MrGaintsquirrel/Kicad_lib/3D drawings/SK34A.step

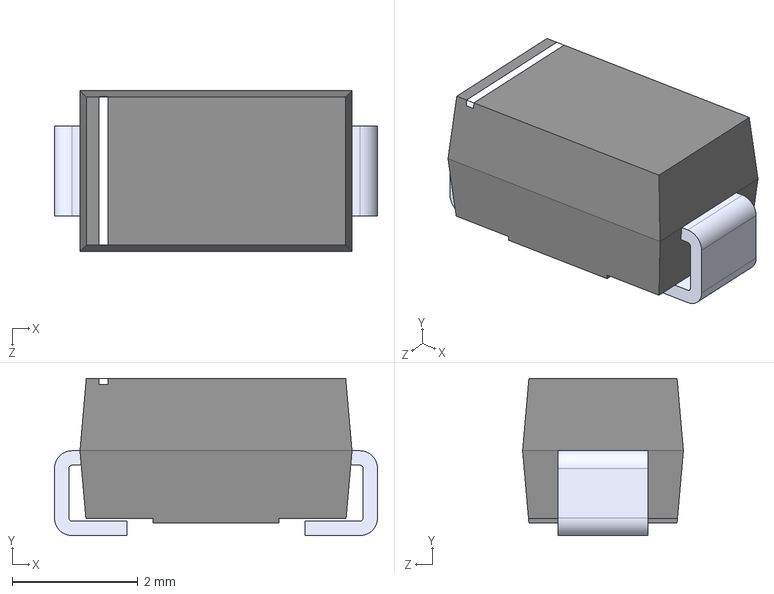
[picture p1: CAD file, 2023-05-01]
3D drawings/SK34A.step
5.14 x 2.50 x 2.56 mm
