MrGaintsquirrel/Kicad_lib/Capacitors/3D_Models/C_0402_1005Metric.step

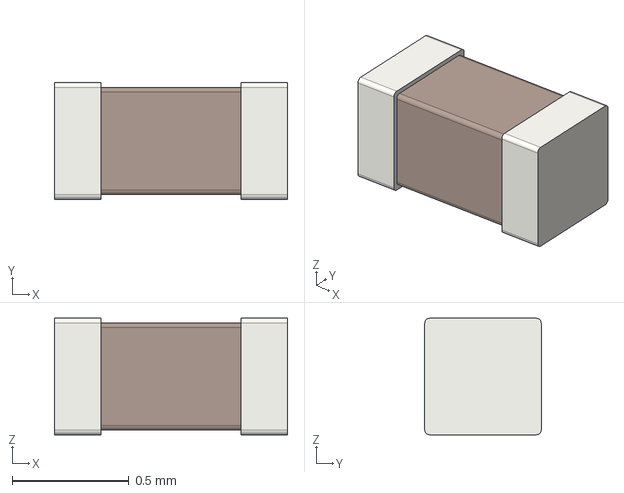
[picture p2: CAD file, 2026-04-26]
Capacitors/3D_Models/C_0402_1005Metric.step
1.00 x 0.5 x 0.5 mm
