MrGaintsquirrel/Kicad_lib/Resistors/3D_Models/R_0402_1005Metric.step

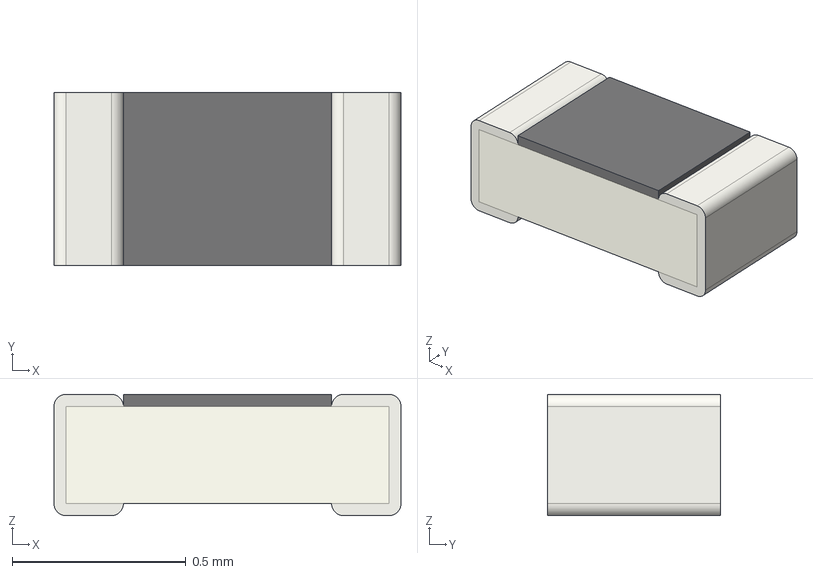
[picture p3: CAD file, 2026-04-26]
Resistors/3D_Models/R_0402_1005Metric.step
1.00 x 0.5 x 0.35 mm
