MrGaintsquirrel/Kicad_lib/STMicroelectronics/3D_Models/STM_LQFP32_5V_LQFP32_ME_V1.step

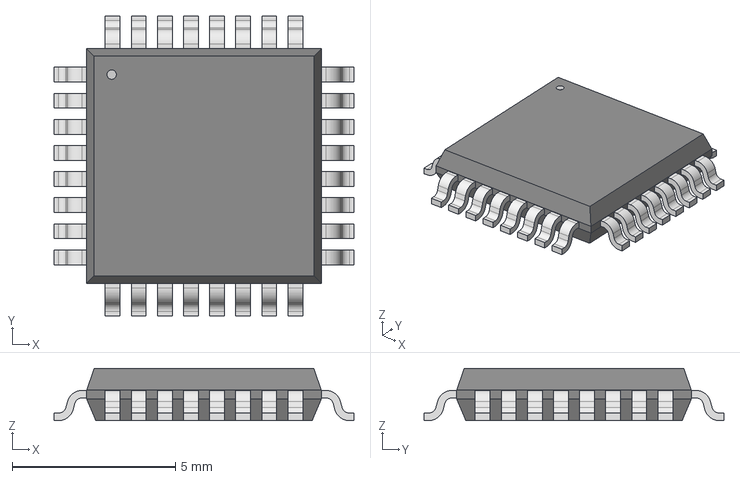
[picture p4: CAD file, 2026-04-29]
STMicroelectronics/3D_Models/STM_LQFP32_5V_LQFP32_ME_V1.step
9.19 x 9.19 x 1.60 mm
