MrGaintsquirrel/Kicad_lib/3D drawings/TO254P1524X483-4N.step

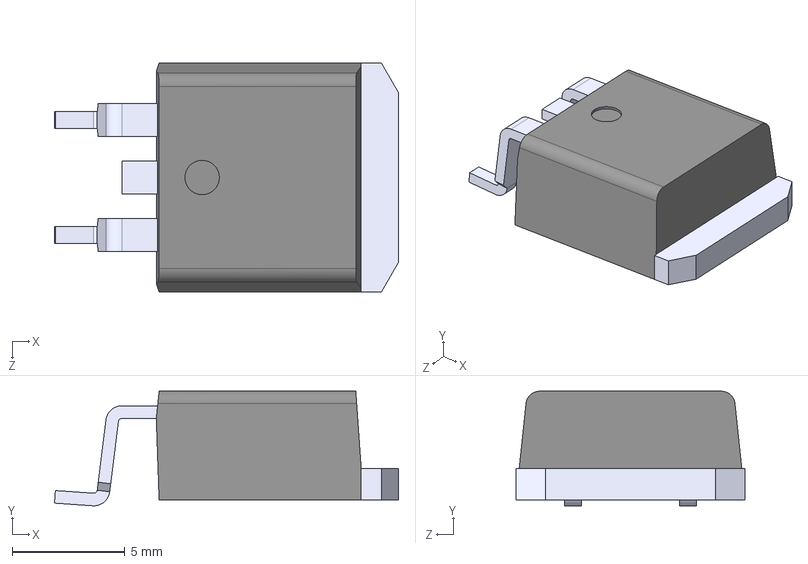
[picture p5: CAD file, 2023-05-01]
3D drawings/TO254P1524X483-4N.step
15.2 x 5.08 x 10.2 mm
