MrGaintsquirrel/Kicad_lib/Capacitors/3D_Models/C_0805_2012Metric.step

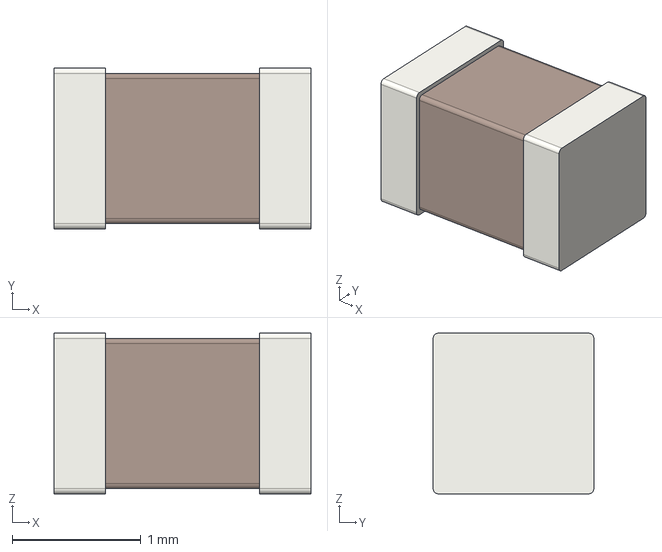
[picture p6: CAD file, 2026-04-26]
Capacitors/3D_Models/C_0805_2012Metric.step
2.00 x 1.25 x 1.25 mm
