MrGaintsquirrel/Kicad_lib/Resistors/3D_Models/R_0805_2012Metric.step

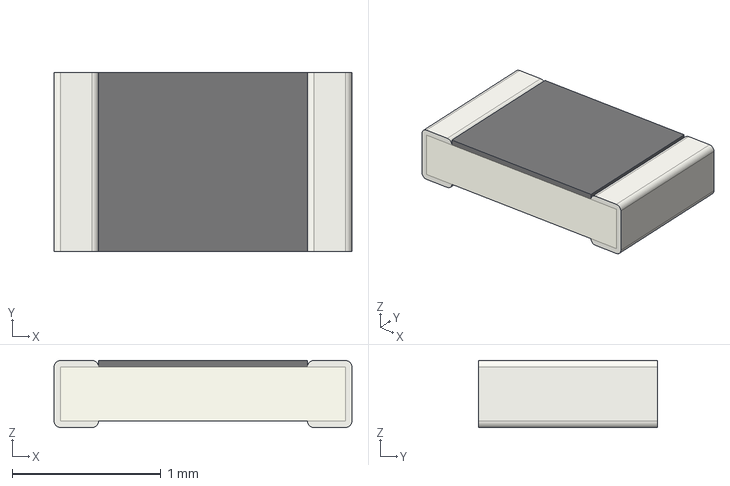
[picture p7: CAD file, 2026-04-26]
Resistors/3D_Models/R_0805_2012Metric.step
2.00 x 1.20 x 0.45 mm
