MrGaintsquirrel/Kicad_lib/STMicroelectronics/3D_Models/STM_UFQFPN48_A0B9_UFQFPN48_ME_V4.step

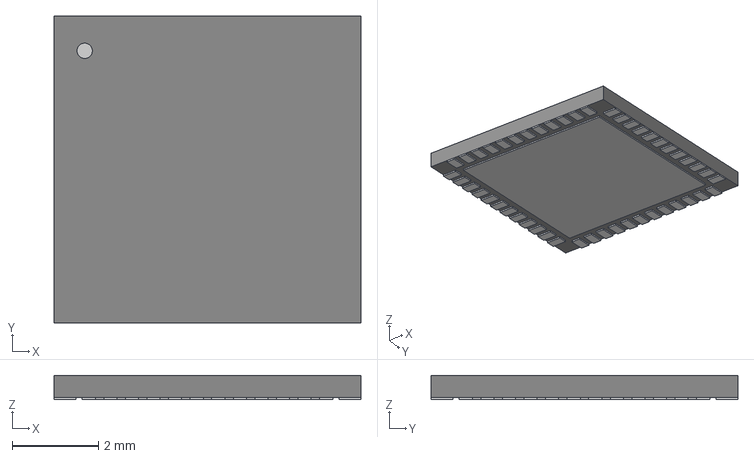
[picture p8: CAD file, 2026-04-29]
STMicroelectronics/3D_Models/STM_UFQFPN48_A0B9_UFQFPN48_ME_V4.step
7.11 x 7.11 x 0.561 mm
