MrGaintsquirrel/Kicad_lib/3D drawings/SRP7050TA.stp

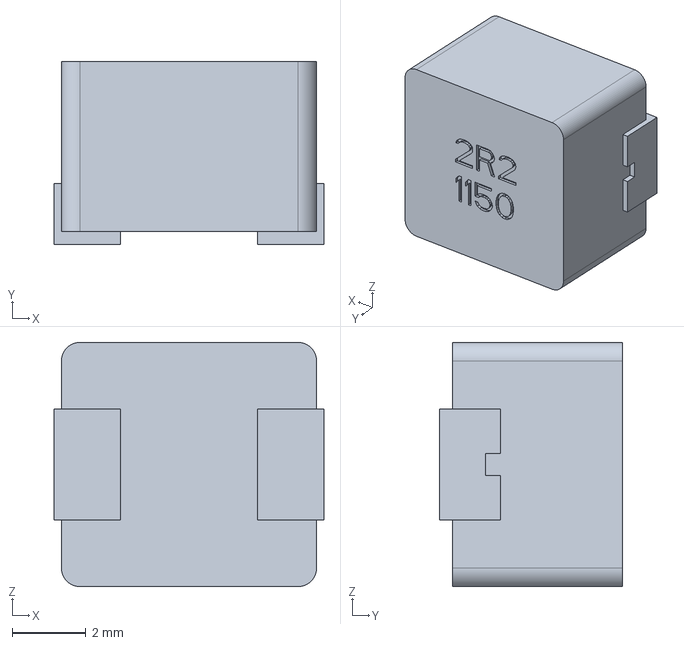
[picture p9: CAD file, 2023-05-01]
3D drawings/SRP7050TA.stp
7.30 x 4.95 x 6.60 mm
