MrGaintsquirrel/Kicad_lib/Capacitors/3D_Models/C_0603_1608Metric.step

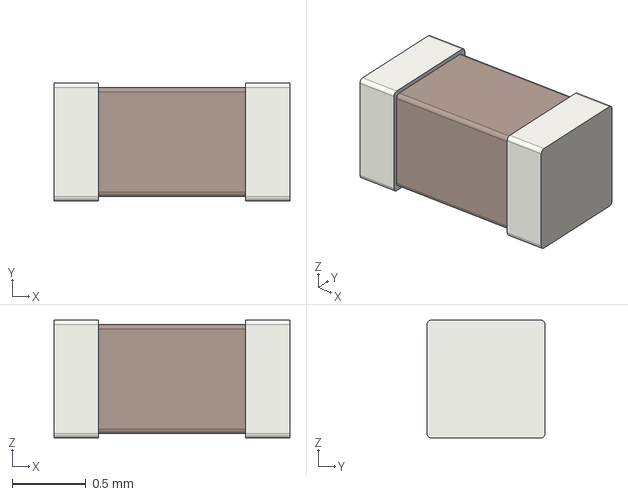
[picture p10: CAD file, 2026-04-26]
Capacitors/3D_Models/C_0603_1608Metric.step
1.60 x 0.8 x 0.8 mm
