MrGaintsquirrel/Kicad_lib/Resistors/3D_Models/R_0603_1608Metric.step

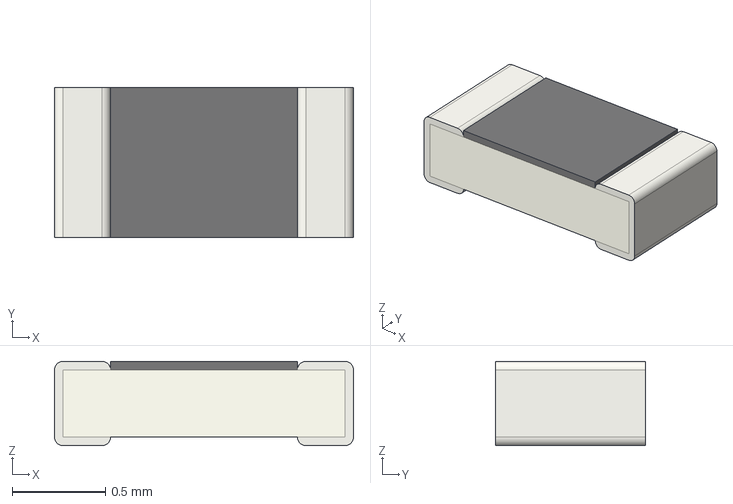
[picture p11: CAD file, 2026-04-26]
Resistors/3D_Models/R_0603_1608Metric.step
1.60 x 0.8 x 0.45 mm
