MrGaintsquirrel/Kicad_lib/STMicroelectronics/3D_Models/STM_UFQFPN24_3Z_UFQFPN24_ME_V3.step

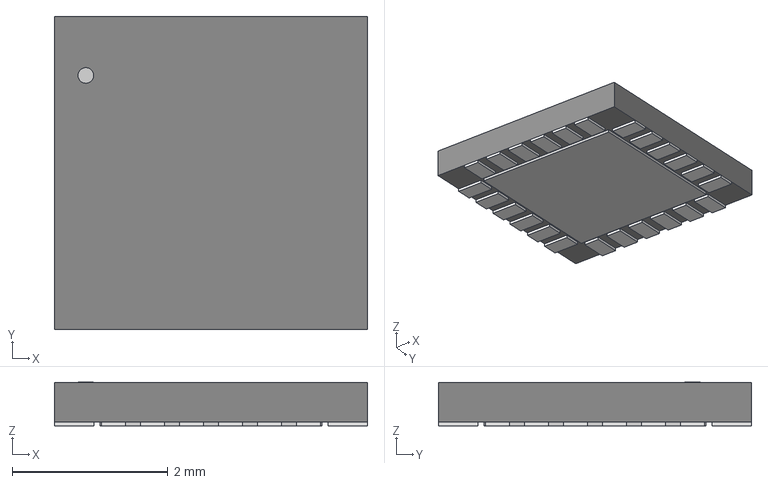
[picture p12: CAD file, 2026-04-29]
STMicroelectronics/3D_Models/STM_UFQFPN24_3Z_UFQFPN24_ME_V3.step
4.01 x 4.01 x 0.561 mm
