MrGaintsquirrel/Kicad_lib/3D drawings/W25Q128JVSIM.stp

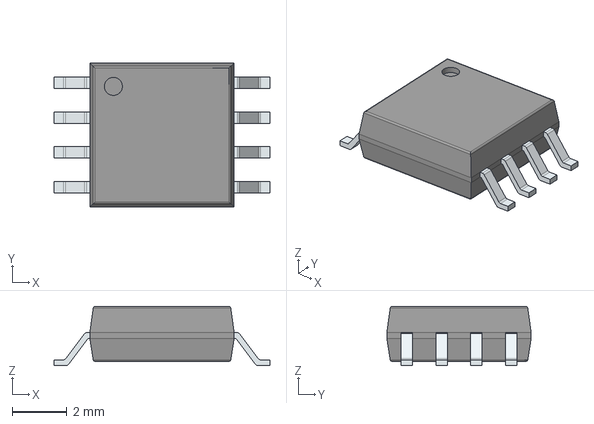
[picture p13: CAD file, 2023-05-01]
3D drawings/W25Q128JVSIM.stp
7.90 x 5.28 x 2.16 mm
PinsArrayLR
