MrGaintsquirrel/Kicad_lib/STMicroelectronics/3D_Models/STM_TSSOP20_YA_ME_V3.step

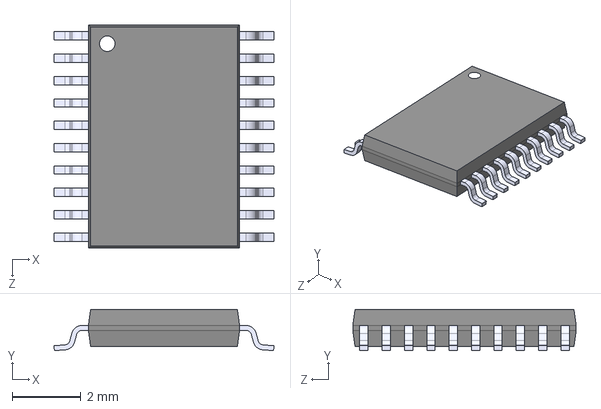
[picture p14: CAD file, 2026-04-29]
STMicroelectronics/3D_Models/STM_TSSOP20_YA_ME_V3.step
6.40 x 1.20 x 6.50 mm
