MrGaintsquirrel/Kicad_lib/3D drawings/MIC2920A-3.3WS-TR.STEP

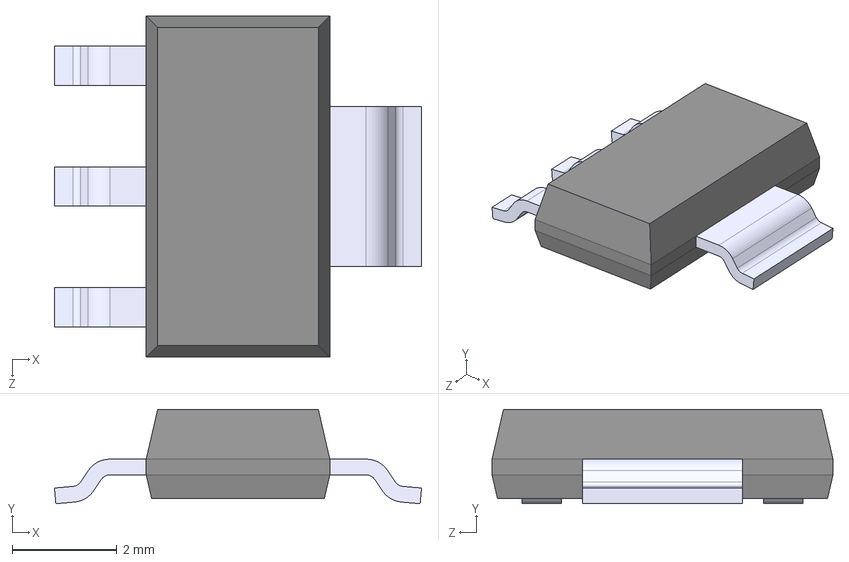
[picture p15: CAD file, 2023-05-01]
3D drawings/MIC2920A-3.3WS-TR.STEP
7.00 x 1.80 x 6.50 mm
