MrGaintsquirrel/Kicad_lib/STMicroelectronics/3D_Models/STM_LQFP64_5W_LQFP64_ME_V1.step

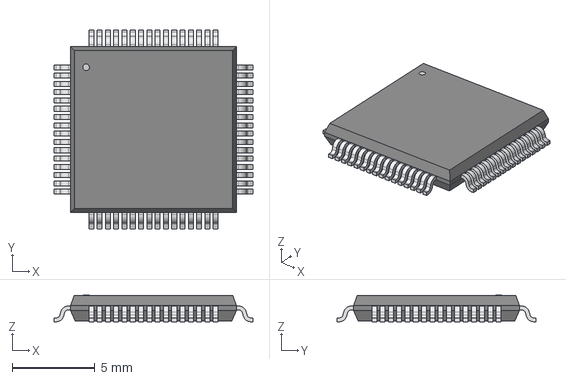
[picture p16: CAD file, 2026-04-29]
STMicroelectronics/3D_Models/STM_LQFP64_5W_LQFP64_ME_V1.step
12.0 x 12.0 x 1.60 mm
