MrGaintsquirrel/Kicad_lib/3D drawings/USB4110-GF-A--3DModel-STEP-269445.STEP

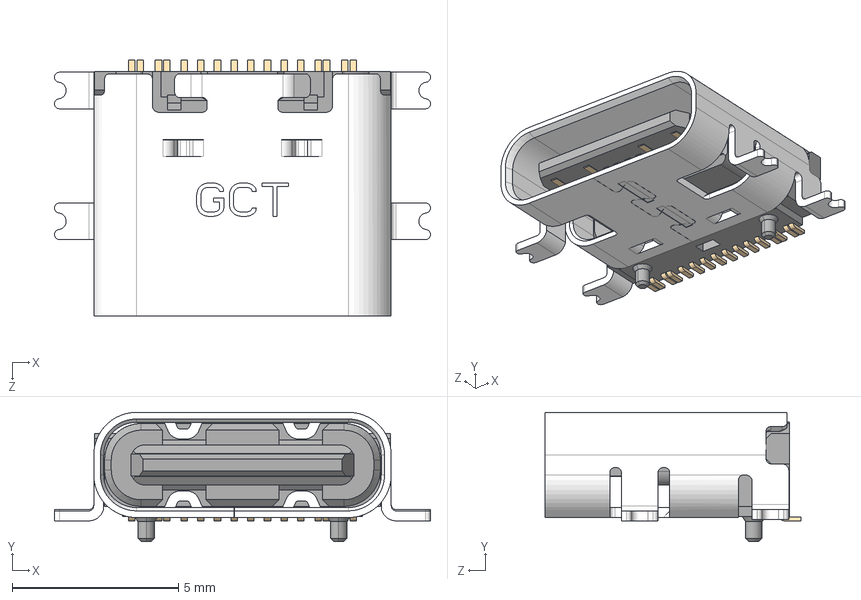
[picture p17: CAD file, 2023-02-09]
3D drawings/USB4110-GF-A--3DModel-STEP-269445.STEP
11.3 x 3.89 x 7.70 mm
