MrGaintsquirrel/Kicad_lib/STMicroelectronics/3D_Models/STM_LQFP48_5B_LQFP48_ME_V1.step

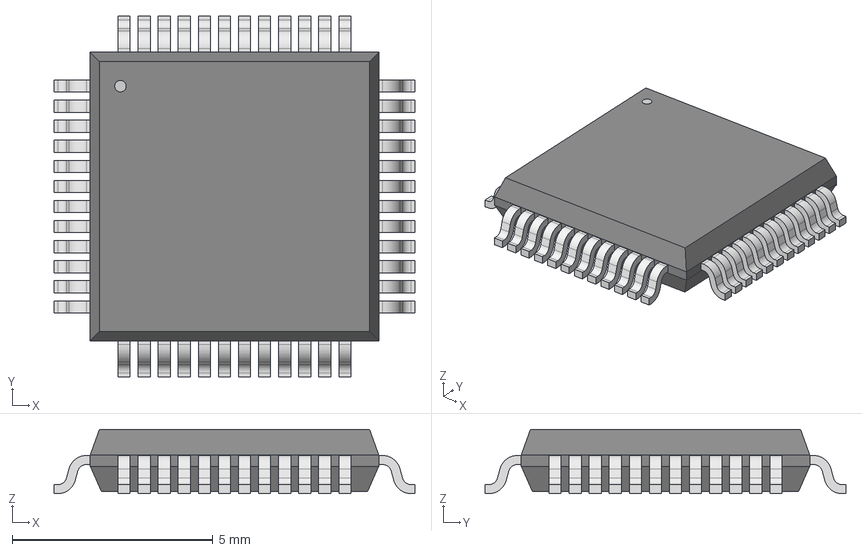
[picture p18: CAD file, 2026-04-29]
STMicroelectronics/3D_Models/STM_LQFP48_5B_LQFP48_ME_V1.step
8.99 x 8.99 x 1.60 mm
