MrGaintsquirrel/Kicad_lib/3D drawings/ECS-520-8-47-CKM-TR.STEP

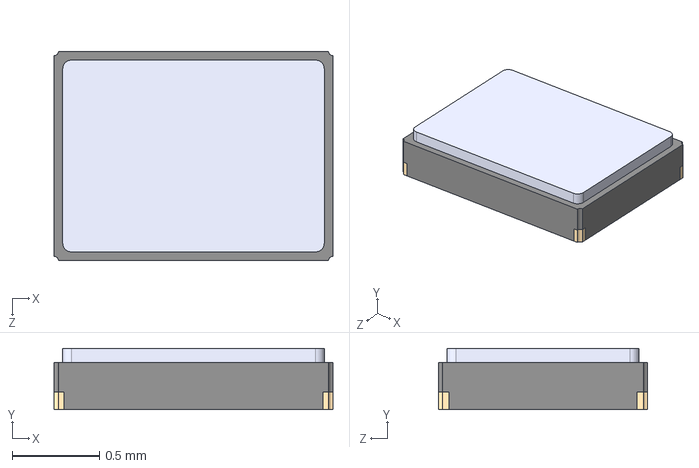
[picture p19: CAD file, 2023-02-08]
3D drawings/ECS-520-8-47-CKM-TR.STEP
1.60 x 0.35 x 1.20 mm
