MrGaintsquirrel/Kicad_lib/STMicroelectronics/3D_Models/STM_UFQFPN32_A0B8_UFQFPN32_ME_V4.step

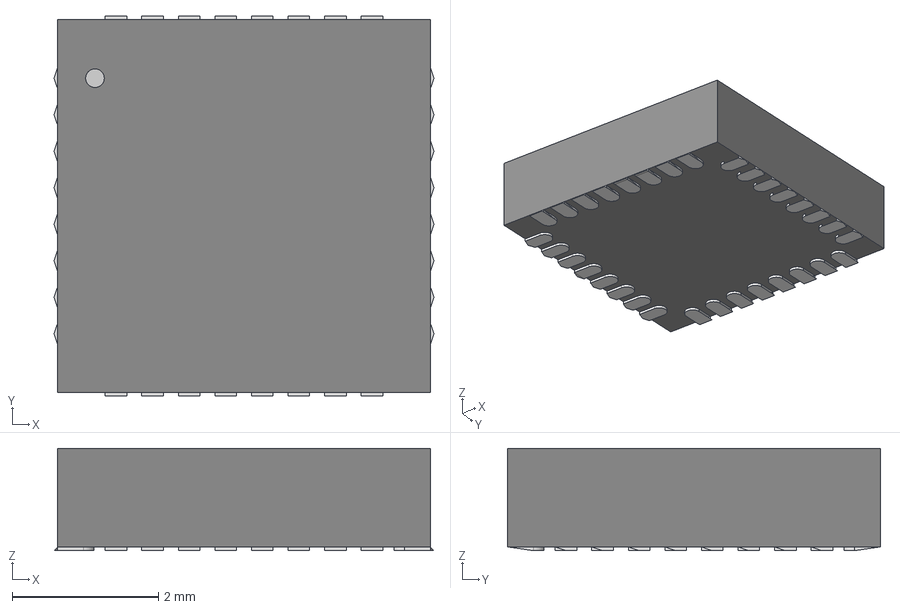
[picture p20: CAD file, 2026-04-29]
STMicroelectronics/3D_Models/STM_UFQFPN32_A0B8_UFQFPN32_ME_V4.step
5.20 x 5.20 x 1.40 mm
