MrGaintsquirrel/Kicad_lib/3D drawings/INDRD500W80D1100H1230-480_Coilcraft_RFS1317_Series_wm.STEP

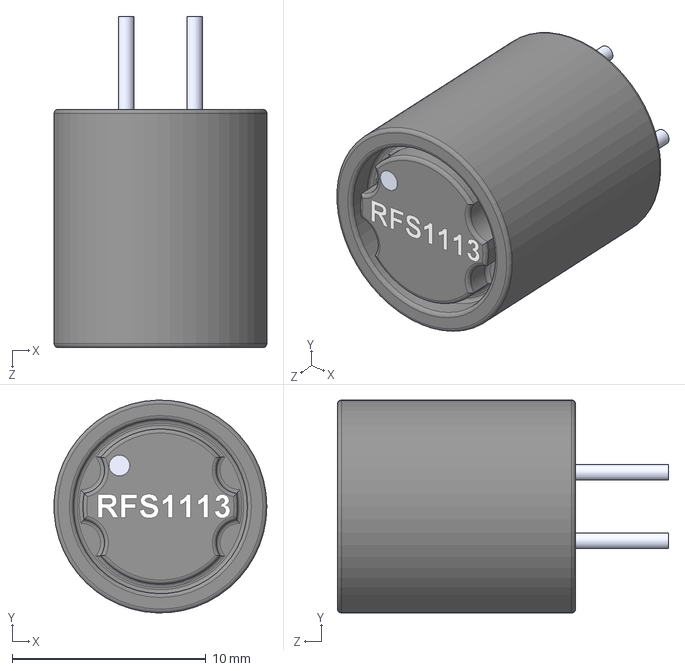
[picture p21: CAD file, 2021-12-18]
3D drawings/INDRD500W80D1100H1230-480_Coilcraft_RFS1317_Series_wm.STEP
11.0 x 11.0 x 17.1 mm
