MrGaintsquirrel/Kicad_lib/STMicroelectronics/3D_Models/STM_UFQFPN20_A0A5_UFQFPN20_ME_V1.step

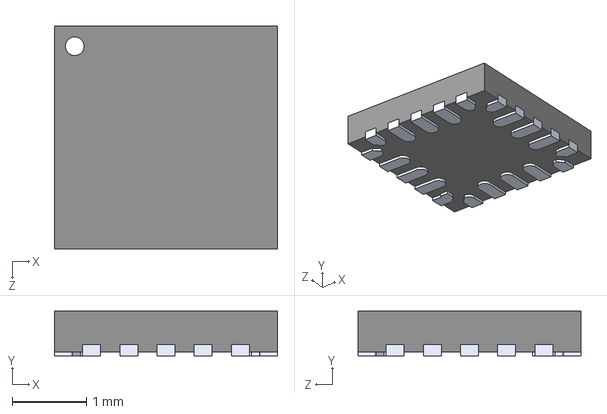
[picture p22: CAD file, 2026-04-29]
STMicroelectronics/3D_Models/STM_UFQFPN20_A0A5_UFQFPN20_ME_V1.step
3.00 x 0.6 x 3.00 mm
