MrGaintsquirrel/Kicad_lib/3D drawings/CUI_DEVICES_SJ1-3523N.step

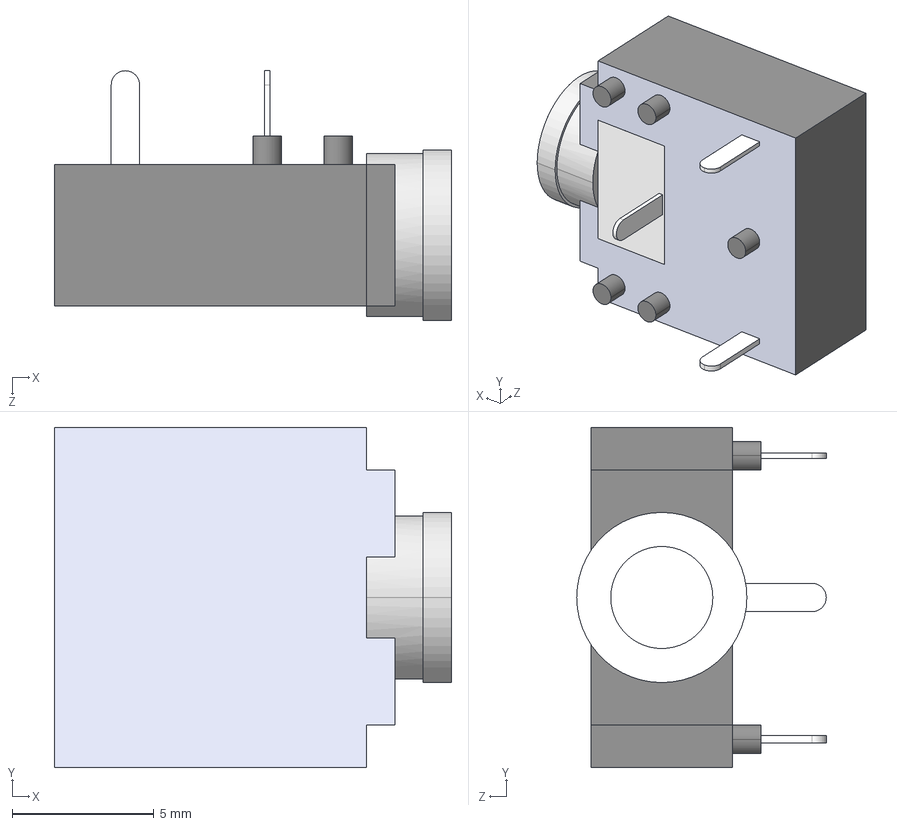
[picture p23: CAD file, 2021-12-09]
3D drawings/CUI_DEVICES_SJ1-3523N.step
14.0 x 12.0 x 8.80 mm
