MrGaintsquirrel/Kicad_lib/3D drawings/DIP-18_W7.62mm.step

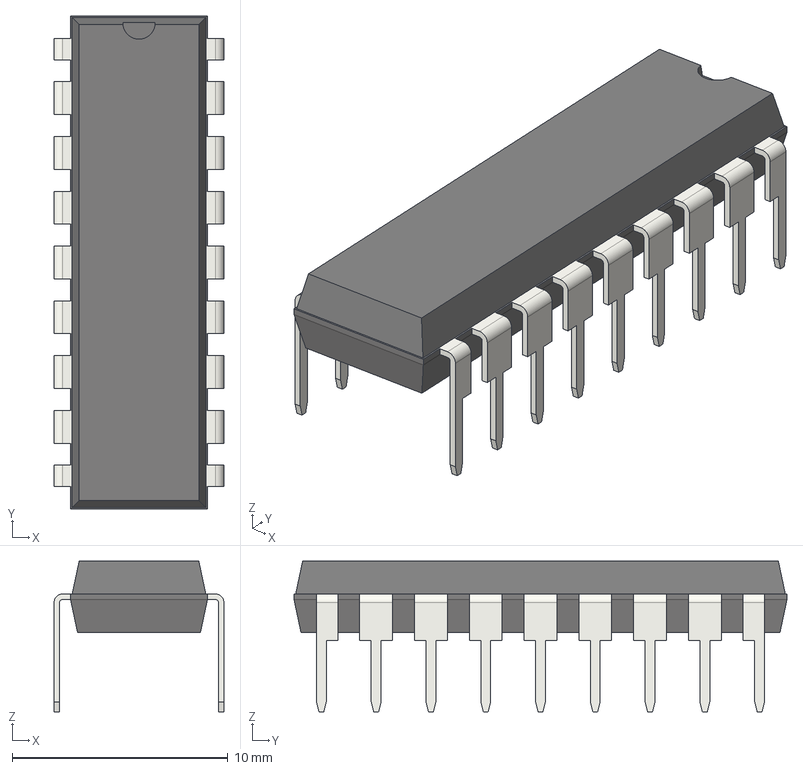
[picture p24: CAD file, 2021-12-09]
3D drawings/DIP-18_W7.62mm.step
7.87 x 22.9 x 6.98 mm
