MrGaintsquirrel/Kicad_lib/3D drawings/1N4148WS.step

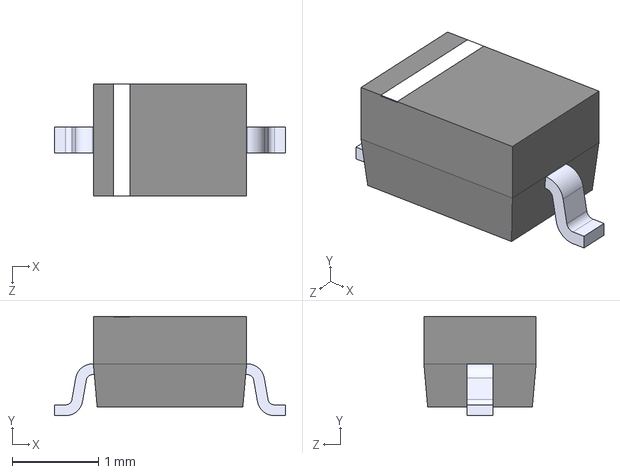
[picture p25: CAD file, 2021-12-09]
3D drawings/1N4148WS.step
2.67 x 1.15 x 1.30 mm
