MrGaintsquirrel/Kicad_lib/3D drawings/DIP-8_W7.62mm.step

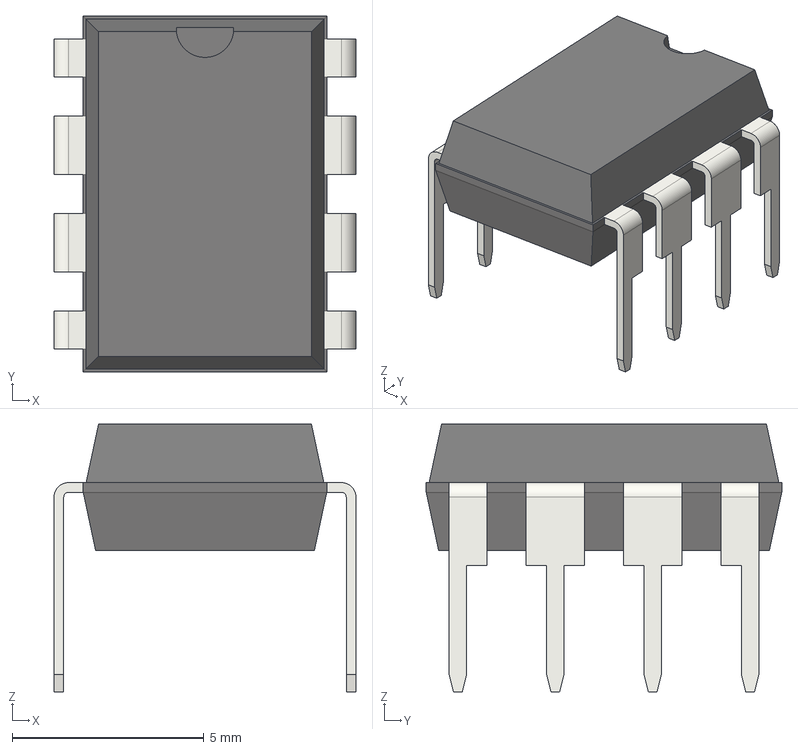
[picture p26: CAD file, 2021-12-09]
3D drawings/DIP-8_W7.62mm.step
7.87 x 9.27 x 6.98 mm
