MrGaintsquirrel/Kicad_lib/3D drawings/Wurth_-_150060RS75000.step

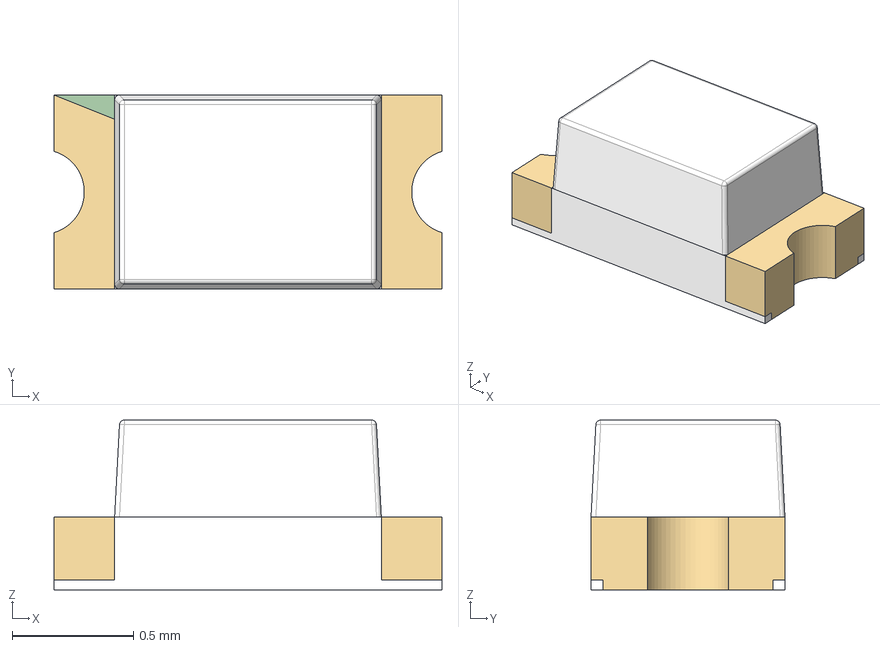
[picture p27: CAD file, 2021-10-19]
3D drawings/Wurth_-_150060RS75000.step
1.60 x 0.8 x 0.7 mm
