MrGaintsquirrel/Kicad_lib/3D drawings/ECWFD2W684J.step

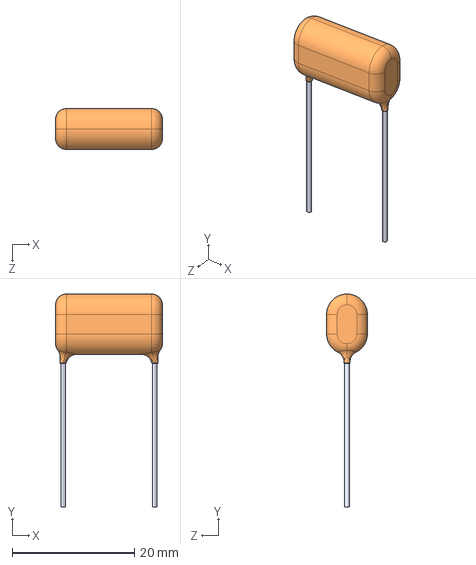
[picture p28: CAD file, 2021-10-18]
3D drawings/ECWFD2W684J.step
17.5 x 34.9 x 6.70 mm
