MrGaintsquirrel/Kicad_lib/3D drawings/Download_STP_WE-TI-8095-7447720xxx (rev1).stp

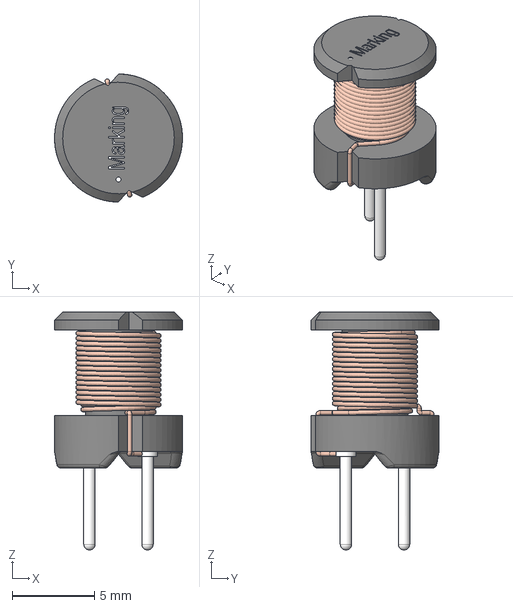
[picture p29: CAD file, 2021-10-18]
3D drawings/Download_STP_WE-TI-8095-7447720xxx (rev1).stp
7.80 x 7.80 x 14.5 mm
Kern x 2
Pin x 2
