MrGaintsquirrel/Kicad_lib/3D drawings/Microchip_-_TC4427CPA.step

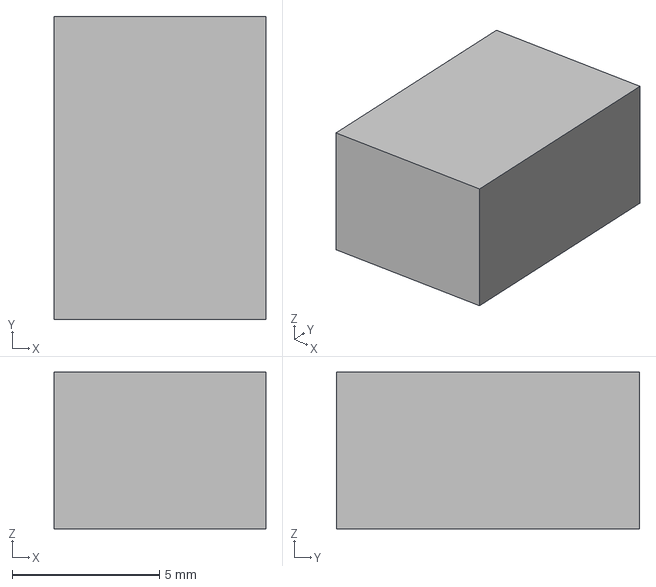
[picture p30: CAD file, 2021-10-14]
3D drawings/Microchip_-_TC4427CPA.step
7.20 x 10.3 x 5.33 mm
