MrGaintsquirrel/Kicad_lib/3D drawings/Infineon_Technologies_AG_-_IRFZ44NPBF.step

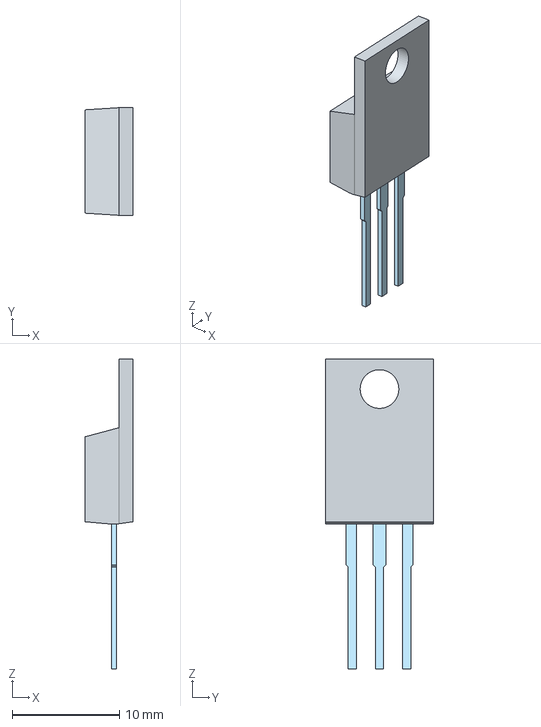
[picture p31: CAD file, 2021-10-14]
3D drawings/Infineon_Technologies_AG_-_IRFZ44NPBF.step
4.44 x 10.0 x 28.9 mm
