MrGaintsquirrel/Kicad_lib/3D drawings/BMA456.step

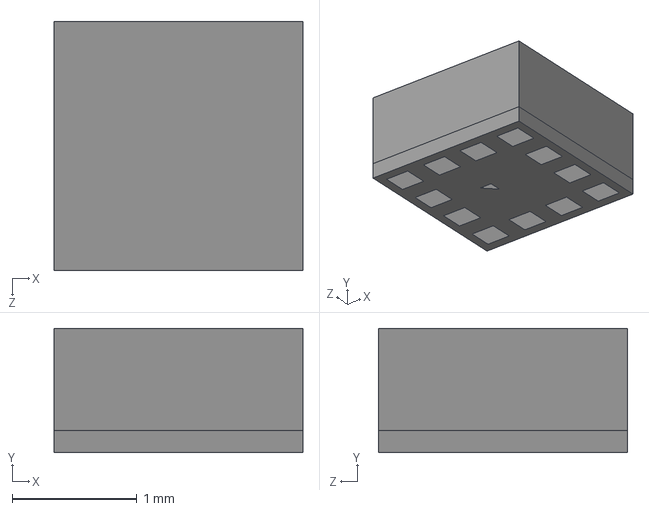
[picture p32: CAD file, 2021-10-12]
3D drawings/BMA456.step
2.00 x 1.00 x 2.00 mm
