MrGaintsquirrel/Kicad_lib/3D drawings/TT_Electronics_-_P160KN-0QD15B10K.step

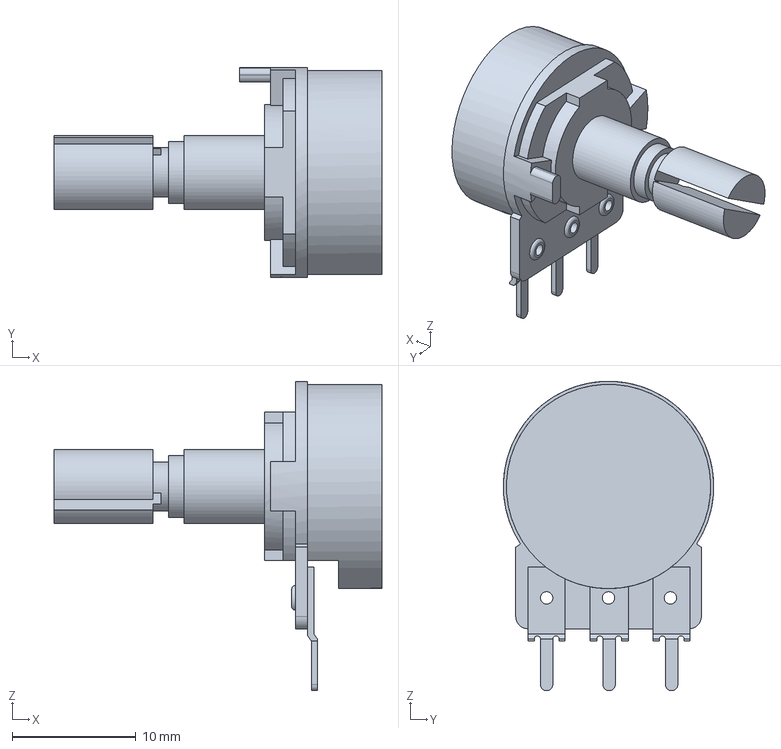
[picture p33: CAD file, 2021-10-12]
3D drawings/TT_Electronics_-_P160KN-0QD15B10K.step
26.5 x 17.0 x 25.0 mm
