MrGaintsquirrel/Kicad_lib/3D drawings/LM317T.step

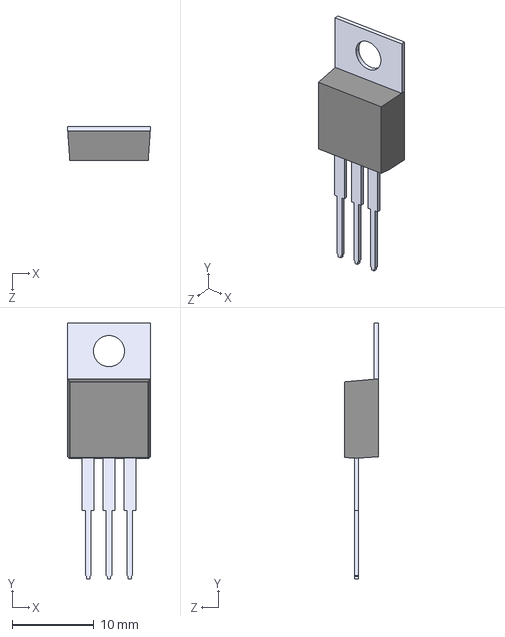
[picture p34: CAD file, 2021-10-12]
3D drawings/LM317T.step
10.2 x 31.2 x 4.20 mm
