MrGaintsquirrel/Kicad_lib/3D drawings/Texas_Instruments_-_LM358AP.step

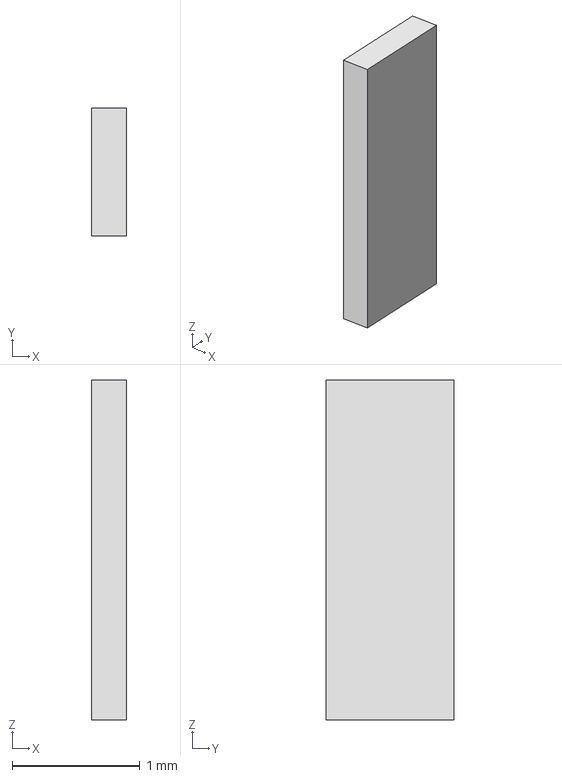
[picture p35: CAD file, 2021-10-12]
3D drawings/Texas_Instruments_-_LM358AP.step
0.27 x 1 x 2.66 mm
