MrGaintsquirrel/Kicad_lib/3D drawings/B2B-PH-K-S(LF)(SN)--3DModel-STEP-56544.STEP

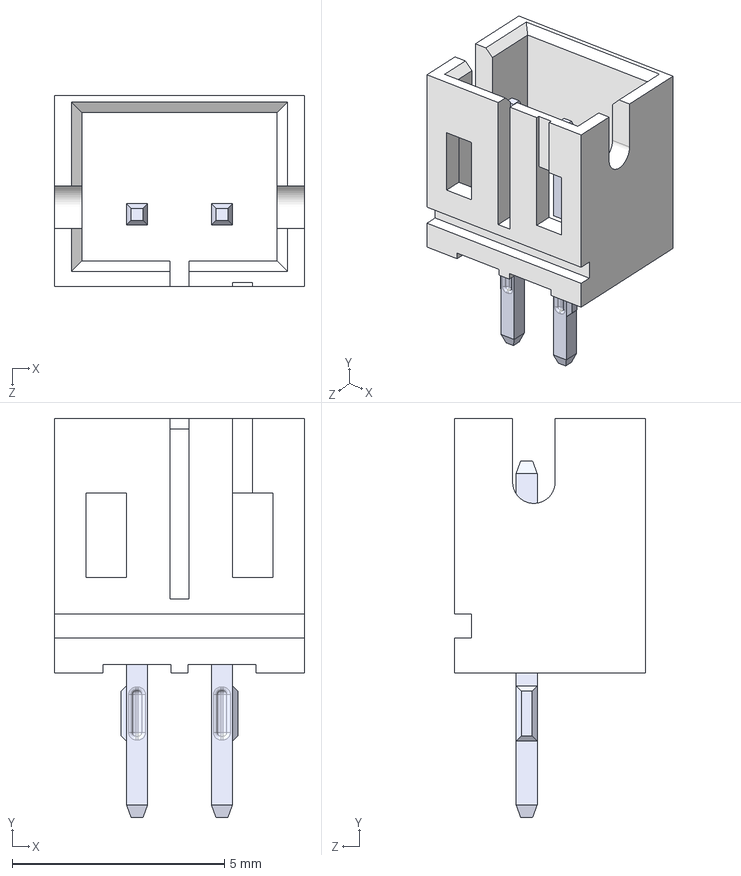
[picture p36: CAD file, 2020-07-22]
3D drawings/B2B-PH-K-S(LF)(SN)--3DModel-STEP-56544.STEP
5.90 x 9.40 x 4.50 mm
