MrGaintsquirrel/Kicad_lib/3D drawings/PTS526_SK15_SMTR2_LFS.stp

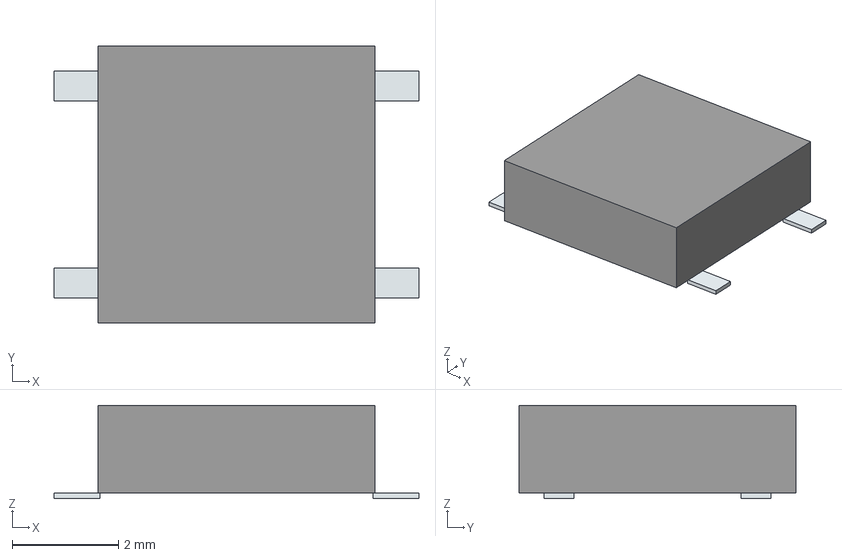
[picture p37: CAD file, 2020-07-15]
3D drawings/PTS526_SK15_SMTR2_LFS.stp
6.86 x 5.20 x 1.75 mm
('pin',_'1')
('pin',_'2')
('pin',_'3')
('pin',_'4')
