MrGaintsquirrel/Kicad_lib/3D drawings/U.FL-R-SMT-1(10)--3DModel-STEP-56544.STEP

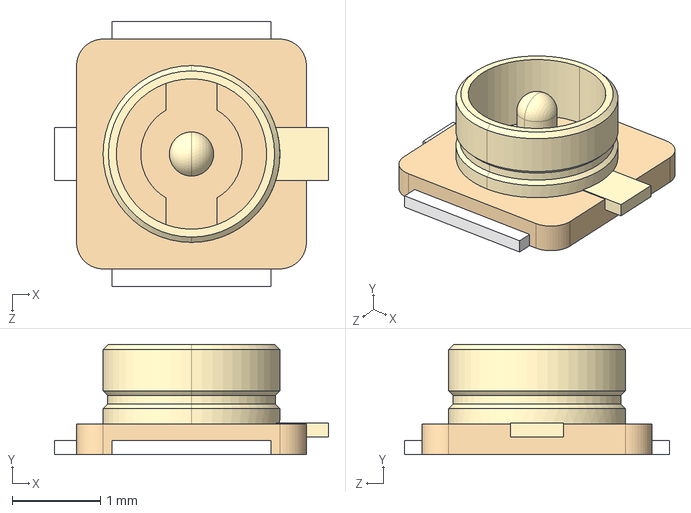
[picture p38: CAD file, 2020-03-19]
3D drawings/U.FL-R-SMT-1(10)--3DModel-STEP-56544.STEP
3.10 x 1.25 x 3.00 mm
