MrGaintsquirrel/Kicad_lib/3D drawings/T494B475K016AT.stp

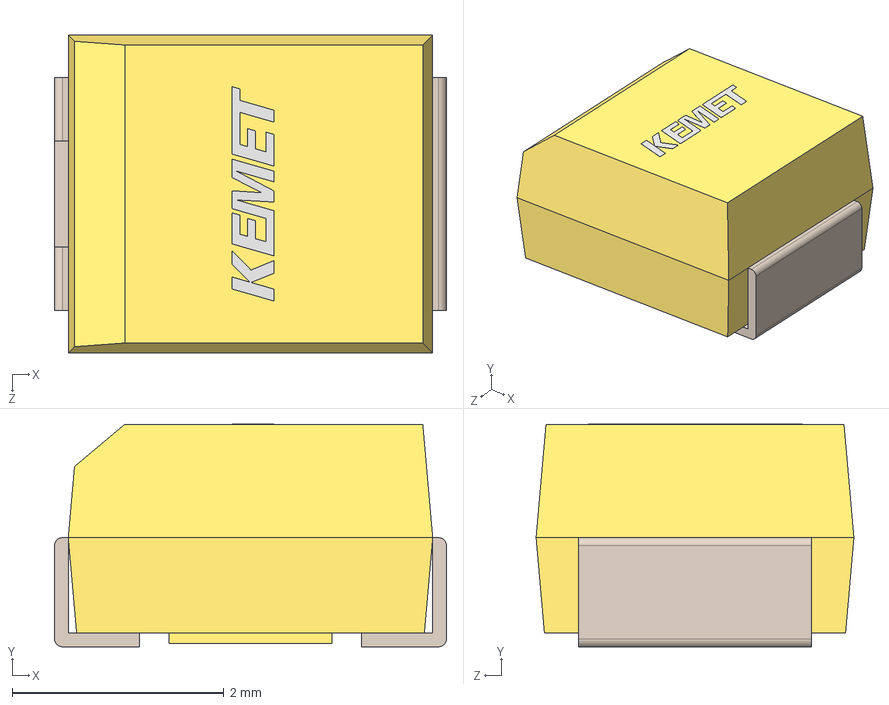
[picture p39: CAD file, 2020-03-19]
3D drawings/T494B475K016AT.stp
3.70 x 2.10 x 3.00 mm
Case_Bottom_1
Case_Top_1
Case_Cathode_1
Case_Anode_1
