MrGaintsquirrel/Kicad_lib/3D drawings/pxc_1729131_07_MKDSN-1-5-3-5-08_3D.stp

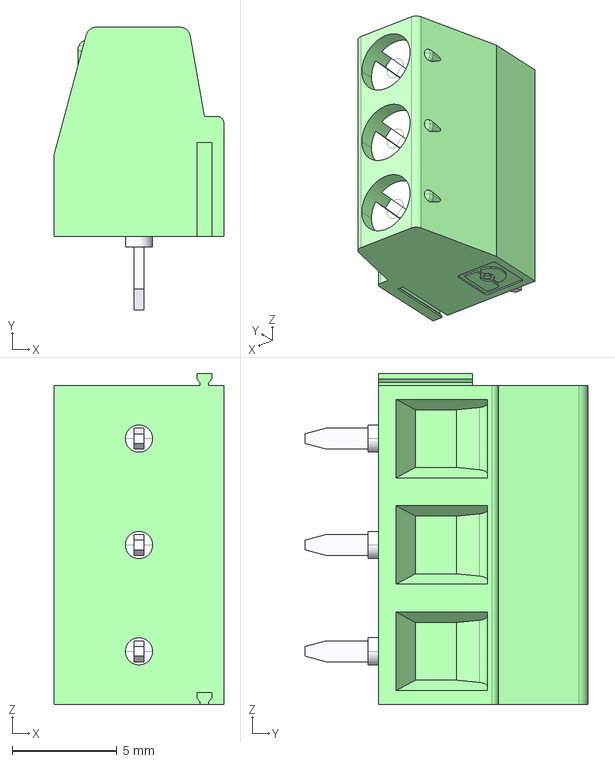
[picture p40: CAD file, 2020-02-17]
3D drawings/pxc_1729131_07_MKDSN-1-5-3-5-08_3D.stp
8.10 x 13.5 x 15.8 mm
