MrGaintsquirrel/Kicad_lib/3D drawings/RFM95W-915S2--3DModel-STEP-56544.STEP

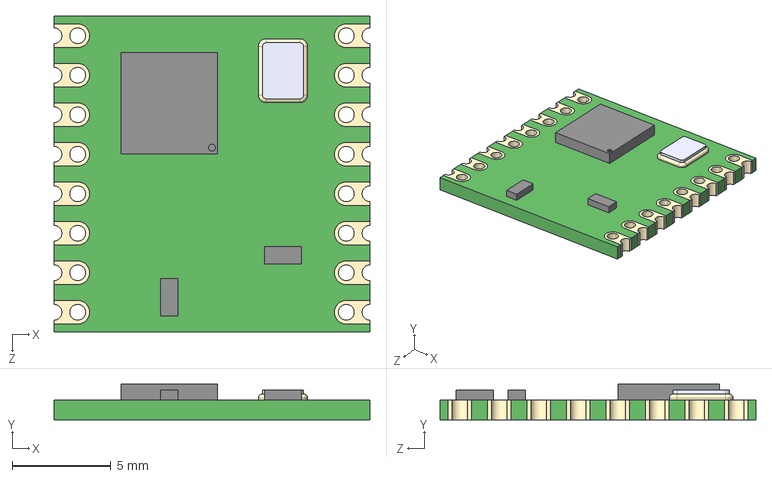
[picture p41: CAD file, 2020-02-17]
3D drawings/RFM95W-915S2--3DModel-STEP-56544.STEP
16.0 x 1.80 x 16.0 mm
