MrGaintsquirrel/Kicad_lib/3D drawings/ATMEGA328P-AU--3DModel-STEP-56544.STEP

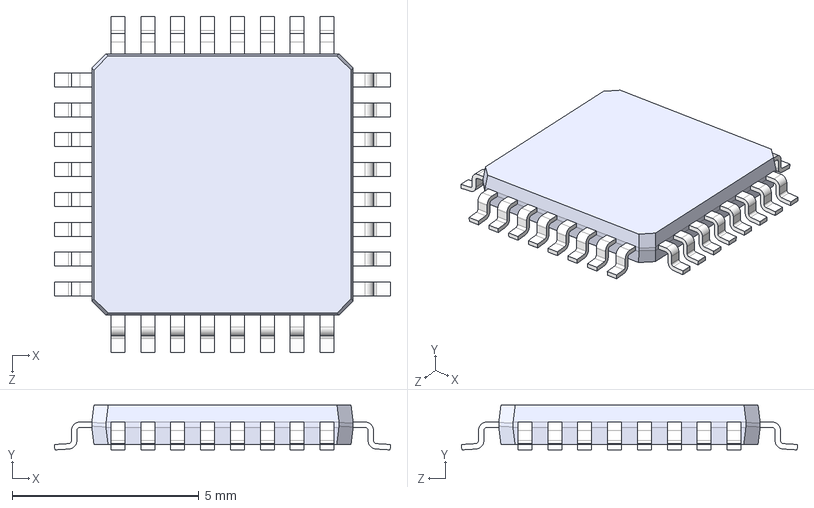
[picture p42: CAD file, 2020-02-09]
3D drawings/ATMEGA328P-AU--3DModel-STEP-56544.STEP
9.00 x 1.20 x 9.00 mm
