MrGaintsquirrel/Kicad_lib/3D drawings/ECS-540-8-33-JTN-TR--3DModel-STEP-56544.STEP

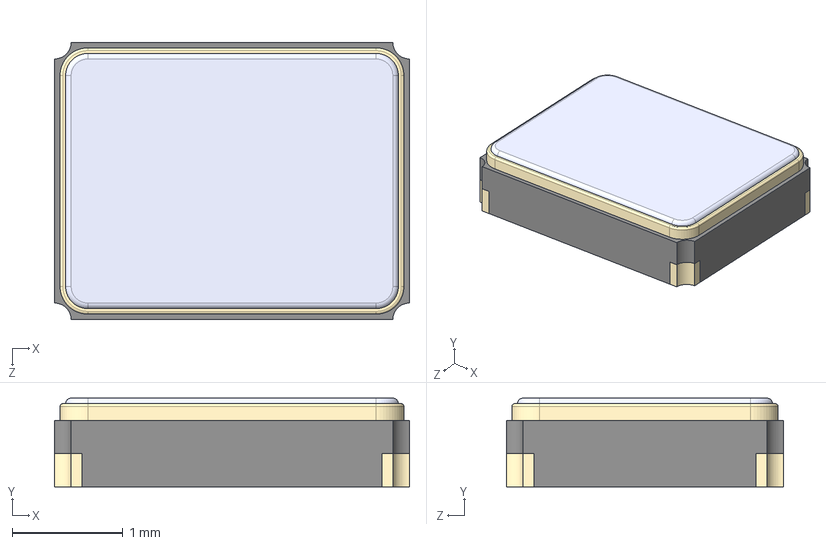
[picture p43: CAD file, 2020-01-09]
3D drawings/ECS-540-8-33-JTN-TR--3DModel-STEP-56544.STEP
3.20 x 0.8 x 2.50 mm
