MrGaintsquirrel/Kicad_lib/3D drawings/LQW15CA22NJ00D.stp

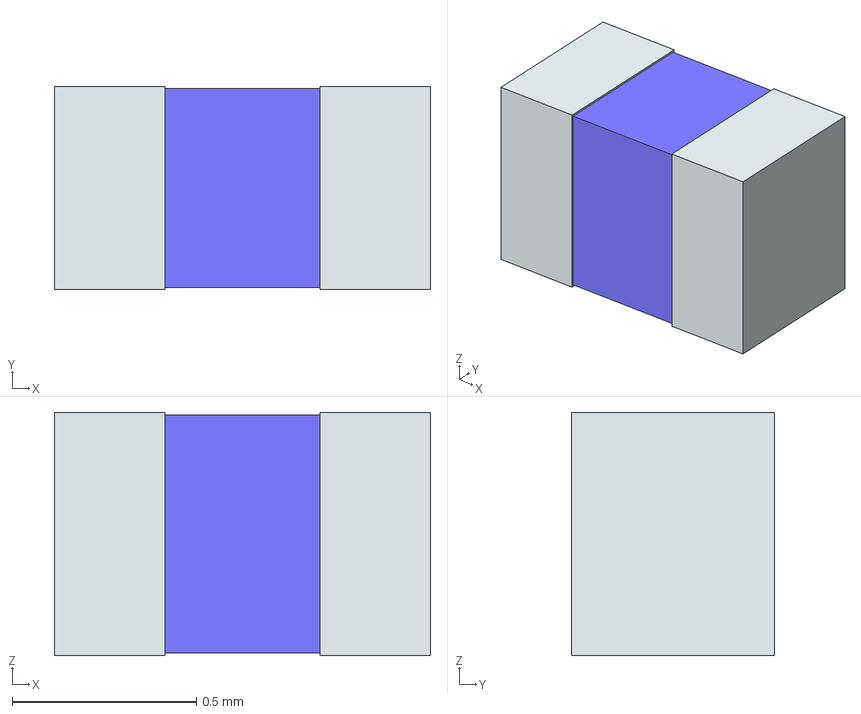
[picture p44: CAD file, 2019-11-20]
3D drawings/LQW15CA22NJ00D.stp
1.02 x 0.55 x 0.66 mm
term1
term2
