MrGaintsquirrel/Kicad_lib/3D drawings/ERA-3AEB2262V.stp

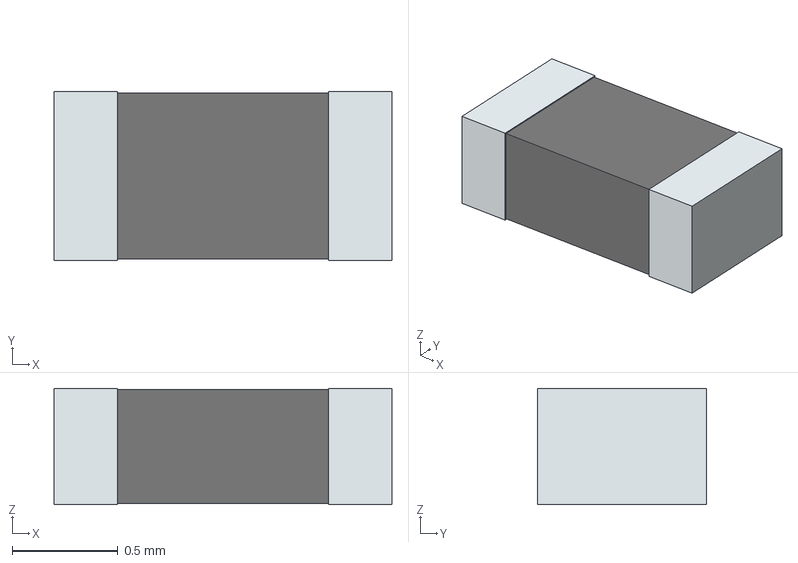
[picture p45: CAD file, 2019-11-20]
3D drawings/ERA-3AEB2262V.stp
1.60 x 0.8 x 0.55 mm
term1
term2
