MrGaintsquirrel/Kicad_lib/3D drawings/DZ2S068C0L.stp

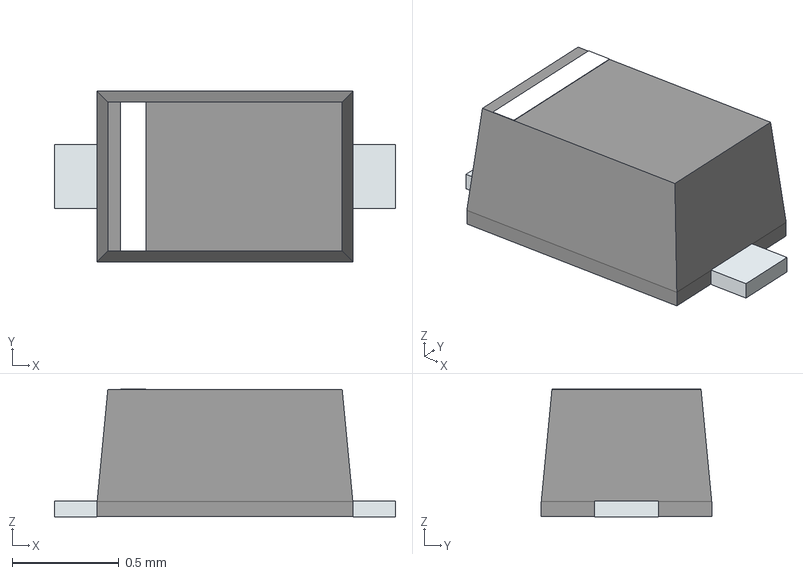
[picture p46: CAD file, 2019-11-20]
3D drawings/DZ2S068C0L.stp
1.60 x 0.8 x 0.6 mm
PinKIdent
PinK
PinA
