MrGaintsquirrel/Kicad_lib/3D drawings/GRM188R11H471KA01D.stp

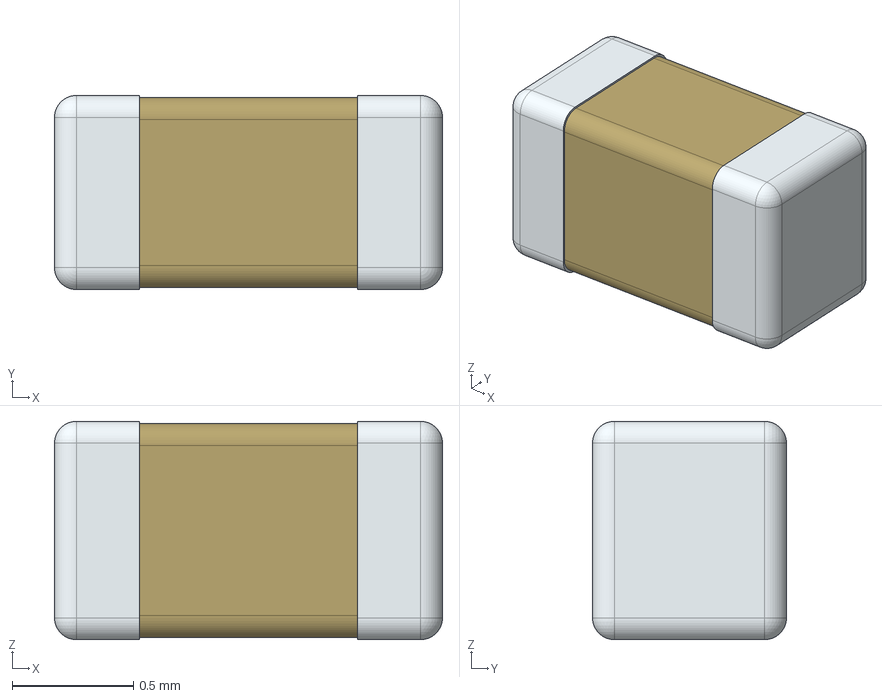
[picture p47: CAD file, 2019-11-20]
3D drawings/GRM188R11H471KA01D.stp
1.60 x 0.8 x 0.9 mm
