MrGaintsquirrel/Kicad_lib/3D drawings/w3214_10_3-2_5.stp

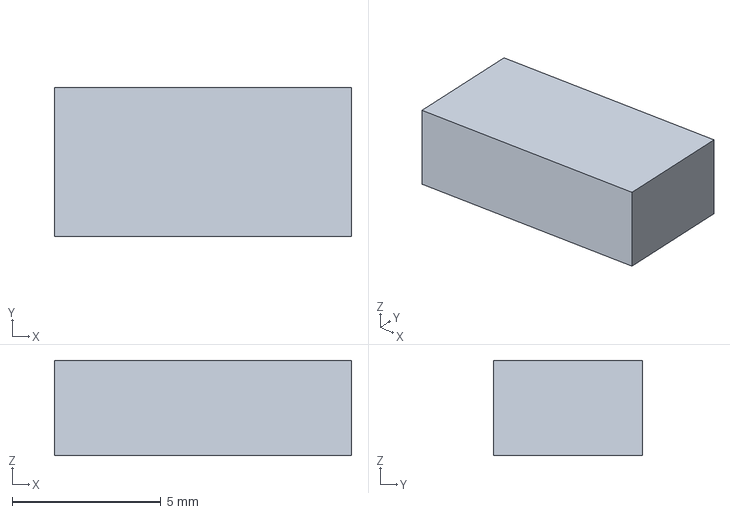
[picture p48: CAD file, 2019-09-29]
3D drawings/w3214_10_3-2_5.stp
10.0 x 5.00 x 3.20 mm
