MrGaintsquirrel/Kicad_lib/3D drawings/IHLP1212BZER3R3M11.stp

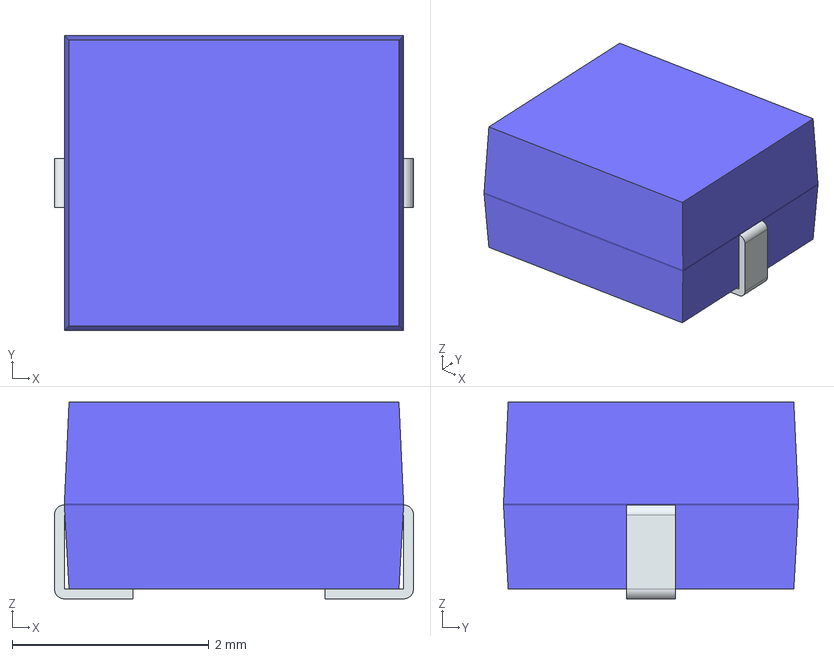
[picture p49: CAD file, 2019-09-29]
3D drawings/IHLP1212BZER3R3M11.stp
3.65 x 3.00 x 2.00 mm
FilletPin1
FilletPin2
