MrGaintsquirrel/Kicad_lib/3D drawings/GRM155C80G106ME44D.stp

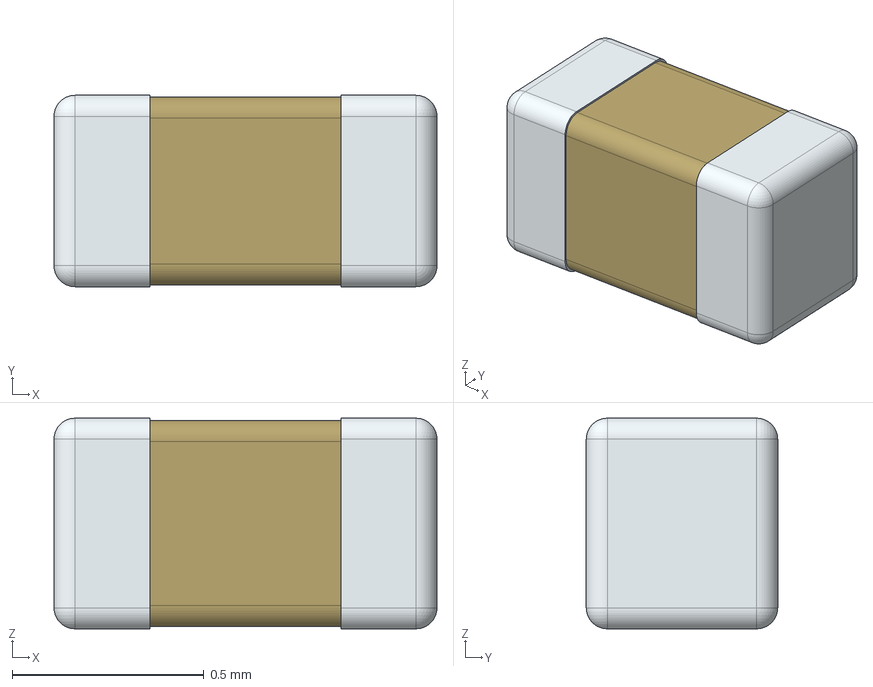
[picture p50: CAD file, 2019-09-27]
3D drawings/GRM155C80G106ME44D.stp
1.00 x 0.5 x 0.55 mm
