MrGaintsquirrel/Kicad_lib/3D drawings/ATSAMR34J18BT-I_7JX.stp

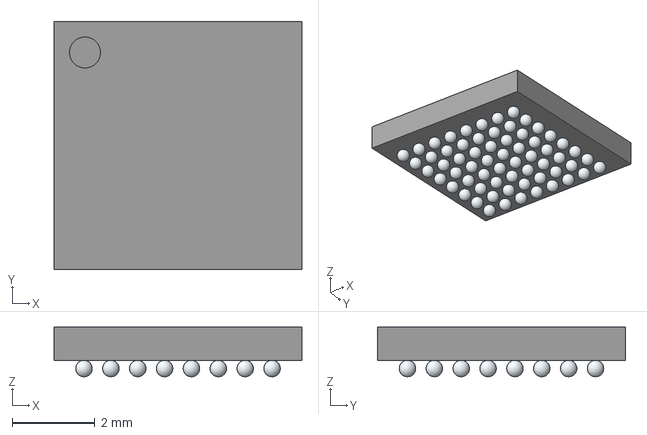
[picture p51: CAD file, 2019-09-27]
3D drawings/ATSAMR34J18BT-I_7JX.stp
6.00 x 6.00 x 1.20 mm
