MrGaintsquirrel/Kicad_lib/3D drawings/ASPI-0630LR.STEP

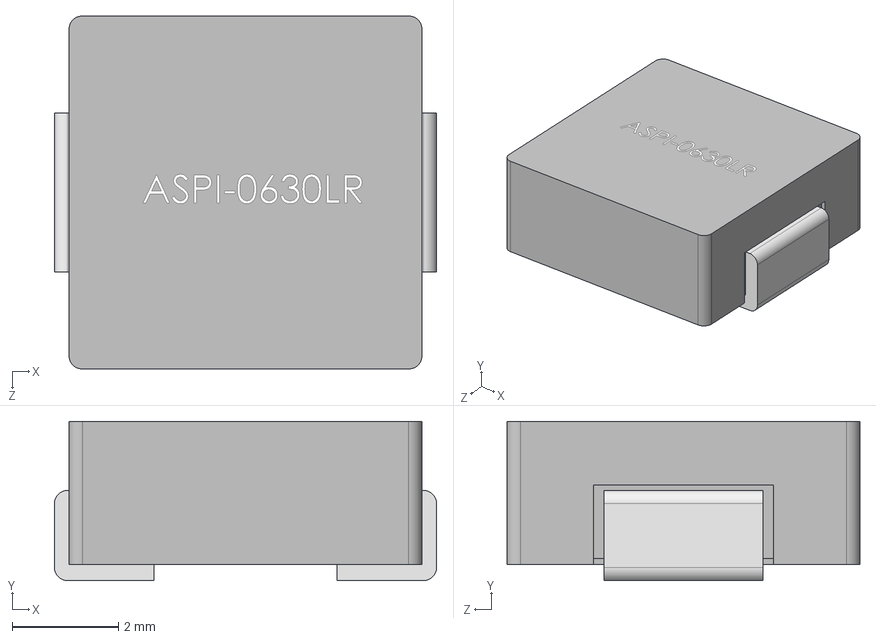
[picture p52: CAD file, 2019-09-27]
3D drawings/ASPI-0630LR.STEP
7.20 x 3.00 x 6.65 mm
