MrGaintsquirrel/Kicad_lib/3D drawings/RC0402FR-07360RL.stp

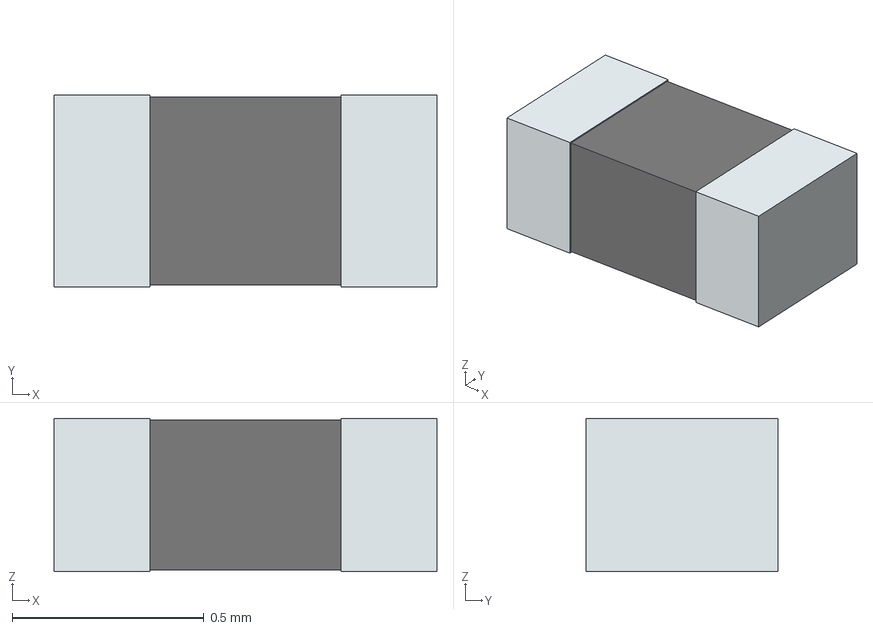
[picture p53: CAD file, 2019-09-27]
3D drawings/RC0402FR-07360RL.stp
1.00 x 0.5 x 0.4 mm
term1
term2
