MrGaintsquirrel/Kicad_lib/3D drawings/SRR4818A.stp

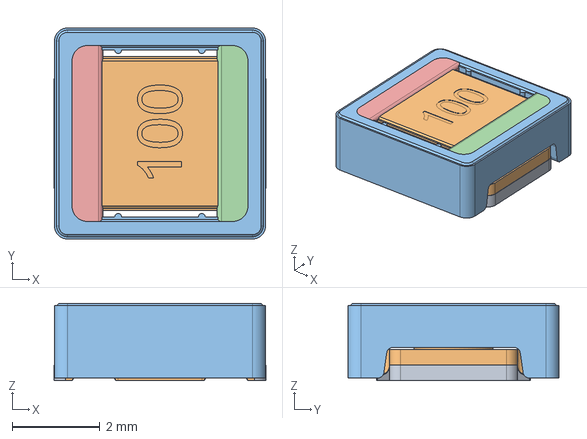
[picture p54: CAD file, 2019-09-27]
3D drawings/SRR4818A.stp
4.82 x 4.80 x 1.76 mm
