MrGaintsquirrel/Kicad_lib/3D drawings/ESD9B3.3ST5G.stp

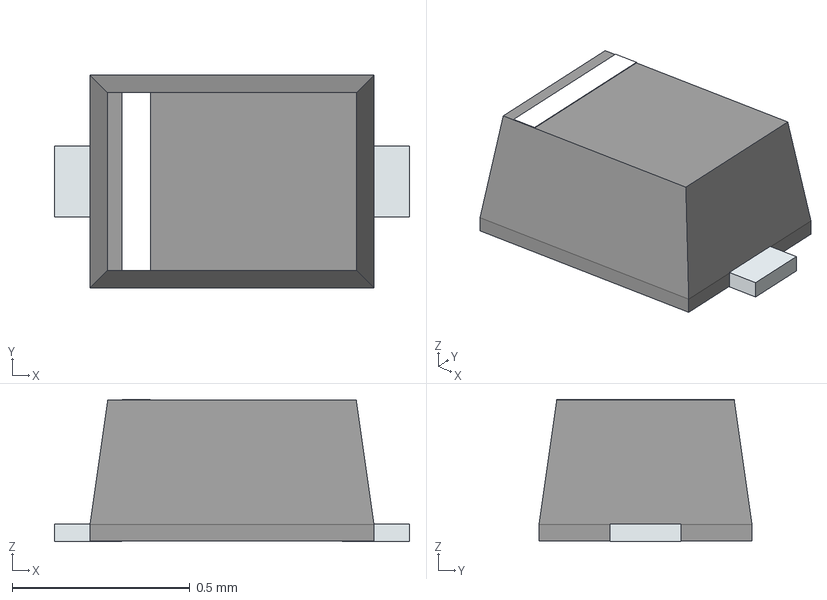
[picture p55: CAD file, 2019-09-27]
3D drawings/ESD9B3.3ST5G.stp
1.00 x 0.6 x 0.4 mm
PinKIdent
PinK
PinA
