MrGaintsquirrel/Kicad_lib/3D drawings/TL3301SPFxxxxG.stp

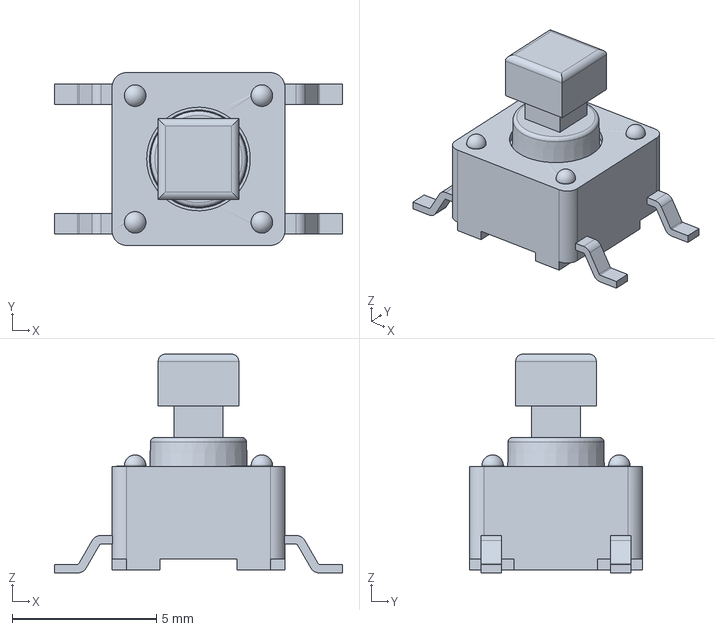
[picture p56: CAD file, 2019-09-27]
3D drawings/TL3301SPFxxxxG.stp
10.0 x 6.00 x 7.60 mm
