MrGaintsquirrel/Kicad_lib/3D drawings/SI2323DS-T1-E3.stp

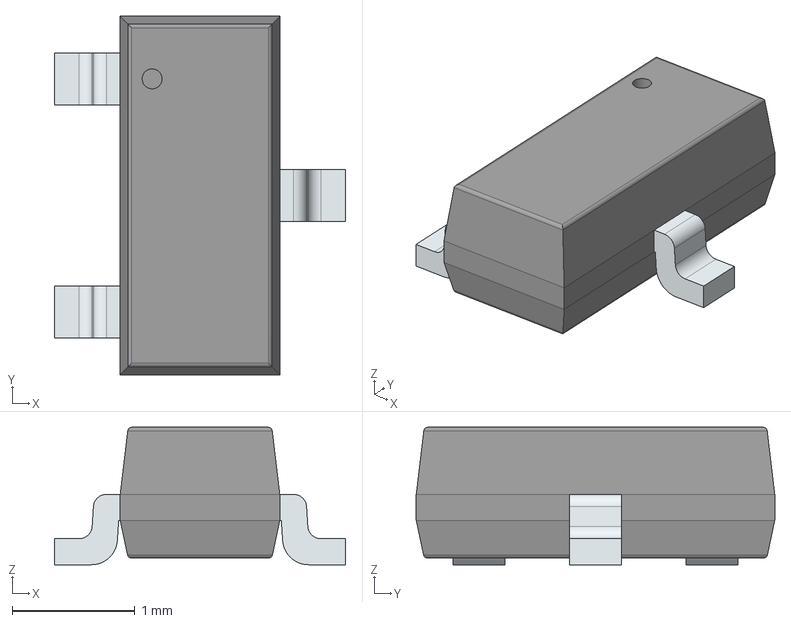
[picture p57: CAD file, 2019-09-27]
3D drawings/SI2323DS-T1-E3.stp
2.37 x 2.92 x 1.12 mm
PinsArrayL
FilletPinR
