MrGaintsquirrel/Kicad_lib/3D drawings/BK-883.STEP

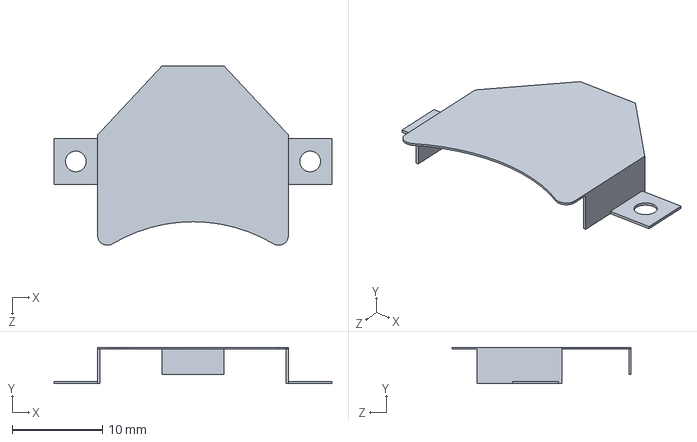
[picture p58: CAD file, 2019-09-27]
3D drawings/BK-883.STEP
30.7 x 4.01 x 19.8 mm
