MrGaintsquirrel/Kicad_lib/3D drawings/w3329_221118.stp

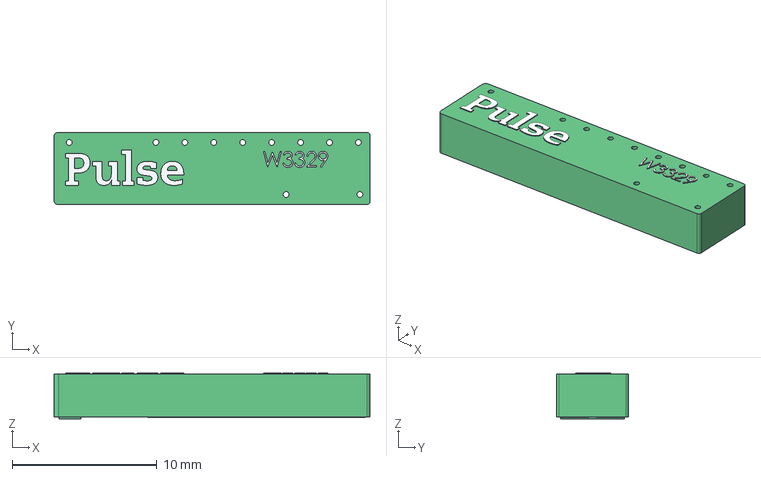
[picture p59: CAD file, 2019-09-27]
3D drawings/w3329_221118.stp
21.8 x 5.00 x 3.17 mm
