MrGaintsquirrel/Kicad_lib/(list of files, cad)

Other CAD files:
3D drawings/022232021.stp
3D drawings/1051330011.stp
3D drawings/150080AS75000_Download_STP_WL-SMCW-0805_rev1.stp
3D drawings/282834-2.step
3D drawings/5031821852--3DModel-STEP-56544.STEP
3D drawings/694102303002.step
3D drawings/TPS61023DRLR.stp
3D drawings/TPS61291DRVR.stp
3D drawings/m20-7820642_asm.stp
3D drawings/m20-7830346_asm.stp
3D drawings/m20-7830446_asm.stp
