MrGaintsquirrel/Kicad_lib/(commit log)

2019-09-27 changed silkscreen
2019-09-27 Added more 3d models for capacitors and resistors, atsamR34
    [ASPI-0630LR.STEP, ATSAMR34J18BT-I_7JX.stp, GRM155C80G106ME44D.stp, RC0402FR-07360RL.stp, SRR4818A.stp]
2019-09-29 added difrent smd antenna and smaller inductor
    [IHLP1212BZER3R3M11.stp, w3214_10_3-2_5.stp]
2019-10-06 added new rf switch and made changes to propperties
    [ARGB1313HS-TR.stp]
2019-10-06 Changed atsamr34 footprint pad dimensions from 0.4 to 0.35
2019-10-12 Added 4V zener diode
2019-10-12 added 4V zener symbol
2019-11-20 added more 3d models and new components
    [DZ2S068C0L.stp, ERA-3AEB2262V.stp, GRM188R11H471KA01D.stp, LQW15CA22NJ00D.stp, TPS61291DRVR.stp]
2020-01-09 added crystal oscilator and made diffrent changes
    [ECS-540-8-33-JTN-TR--3DModel-STEP-56544.STEP]
2020-02-09 added atmega 328P
    [ATMEGA328P-AU--3DModel-STEP-56544.STEP]
2020-02-10 fixed tactile switch
2020-02-17 added new components
    [RFM95W-915S2--3DModel-STEP-56544.STEP, pxc_1729131_07_MKDSN-1-5-3-5-08_3D.stp]
2020-02-17 added more components
    [1051330011.stp, 5031821852--3DModel-STEP-56544.STEP]
2020-03-19 added more inductors and capacitors
    [T494B475K016AT.stp, TPS61023DRLR.stp, U.FL-R-SMT-1(10)--3DModel-STEP-56544.STEP]
2020-03-31 more components
    [m20-7820642_asm.stp, m20-7830346_asm.stp, m20-7830446_asm.stp]
2020-07-12 new componnents
    [022232021.stp, 150080AS75000_Download_STP_WL-SMCW-0805_rev1.stp, PTS526_SK15_SMTR2_LFS.stp]
2020-07-22 added jst-ph connector
    [B2B-PH-K-S(LF)(SN)--3DModel-STEP-56544.STEP]
2020-08-05 updated Green LED footprint
2021-10-14 added mosfet and tc4427
    [Infineon_Technologies_AG_-_IRFZ44NPBF.step, Microchip_-_TC4427CPA.step]
2021-10-18 added capacitors and resistors
2021-10-18 added capacitors and inductors
    [Download_STP_WE-TI-8095-7447720xxx (rev1).stp, ECWFD2W684J.step]
2021-10-19 added components
    [694102303002.step, Wurth_-_150060RS75000.step]
2021-12-06 added new inductor
    [282834-2.step]
2021-12-09 added diodes and resistors
    [1N4148WS.step, CUI_DEVICES_SJ1-3523N.step, DIP-18_W7.62mm.step, DIP-8_W7.62mm.step]
2021-12-10 added diode 3d model
2021-12-18 changed partnumbers
    [INDRD500W80D1100H1230-480_Coilcraft_RFS1317_Series_wm.STEP]
2023-02-08 updated Capacitor and resistor symbols
    [ECS-520-8-47-CKM-TR.STEP]
2023-02-09 added symbols and footprint
    added usb-c connector
    [USB4110-GF-A--3DModel-STEP-269445.STEP]
2026-01-04 Updated to new kicad format
2026-01-04 Added symbol templates
    Created polarized and non polarized capacitor symbols and templates. These can be used to create componentes for capacitors from different manufacterurs
2026-01-09 added tdk capacitor parts
2026-01-18 added gitignore file
    updated property and added 0603 pcb footprint link
2026-01-18 Update Main_Capacitor_Library.kicad_sym
    added new tdk capacitor parts from the
    C1608 series
2026-01-18 Added TDK capacitors form C1608 Series
2026-01-21 restructered capacitor files
2026-01-24 Created Wurth capacitor library
    Added capacitors from generic csgp series for 0603 case size's
2026-01-24 updated wurth capacitor library
    added 0402 series
2026-01-27 First steps for resistors
    Created seperate folder for resistors
    created template symbol
2026-04-26 added yageo resistors
    Added yageo resistor series
    - Yageo series RC for thick film: 0402, 0603 and 0805.
    - Yageo series RT for thin film: 0402, 0603 and 0805.
2026-04-26 Restructerd files
    Restructerd files and created folders for brand seperation and generic footprints
2026-04-26 Added footprints to library
    Added folder for footprints for resistors.
    copied existing footprints from official kicad library.
    [R_0402_1005Metric.step, R_0603_1608Metric.step, R_0805_2012Metric.step]
2026-04-26 Changed files
    Copied footprints from official kicad library.
    recreated path variables to local folder structure inside capacitor library.
    Created brand seperated folders
    [C_0402_1005Metric.step, C_0603_1608Metric.step, C_0805_2012Metric.step]
2026-04-27 Renamed Wurth elektronik capacitor file
    Renamed Wurth Elektronik capacitor file to represend correct WCAP-CSGP series
2026-04-27 Added TSSOP20 package
    Added TSSOP20 Package.
    [STM_TSSOP20_YA_ME_V3.step, STM_UFQPN20_A0A5_UFQFPN20_ME_V1.step]
2026-04-27 Added QFN24 footprint
2026-04-28 Created footprint
    Added 3d model for UFQFPN24.
    Created LQFP32.
    Added 3d model for LQFP32
    [STM_LQFP32_5V_LQFP32_ME_V1.step, STM_UFQFPN24_3Z_UFQFPN24_ME_V3.step]
2026-04-28 Created new footprints and added max height
    Created STM_LQFP48_5B_LQFP48_ME_V1
    STM_UFQFPN32_A0B8_UFQFPN32_ME_V4
    Added max height to all footprints from STMicroelectronics
    [STM_LQFP48_5B_LQFP48_ME_V1.step, STM_UFQFPN32_A0B8_UFQFPN32_ME_V4.step]
2026-04-29 Added new footprints
    Added DT_A0B9_UFQFPN48_ME_V5
    Added 5W_LQFP64_ME_V1
    changed silkscreen width to 0.15mm
    [STM_LQFP64_5W_LQFP64_ME_V1.step, STM_UFQFPN20_A0A5_UFQFPN20_ME_V1.step, STM_UFQFPN48_A0B9_UFQFPN48_ME_V4.step]
2026-05-02 Added sysmbols for STM32C5 series
    Created symbol templates for different 20, 24, 32, 48 pin packages.
    Created parts derived from template symbol.
2026-05-03 Added STM32C5 Symbols
    Created 48 pin UFQFN symbol.
    created 64 Pin TQFP symbol
2026-05-03 Added STM32C542 series
    Added STM32C542 series devices to STM32C5 Symbol library
