MrGaintsquirrel/Kicad_lib/(notices)

Notices in the files:
Resistors/3D_Models/R_0603_1608Metric.step:
Copyright (C) 2018, kicad StepUp
This work is licensed under the [Creative Commons CC-BY-SA 4.0 License](https://creativecommons.org/licenses/by-sa/4.0/legalcode),
with the following exception:
To the extent that the creation of electronic designs that use 'Licensed Material' can be considered to be 'Adapted Material',
You are free to use the library data in your own projects without the obligation to share your project files under this or any other license agreement.
3D drawings/DIP-8_W7.62mm.step:
Copyright (C) 2017, your name
This program is free software: you can redistribute it and/or modify
it under the terms of the GNU General Public License as published by
the Free Software Foundation, either version 3 of the License, or
any later version.
itself might be covered by the GNU General Public License.
Capacitors/3D_Models/C_0402_1005Metric.step:
Copyright (C) 2017, kicad StepUp
